CarlKuhligk/ATtiny85-Fan-Controller/documentation/box.PNG

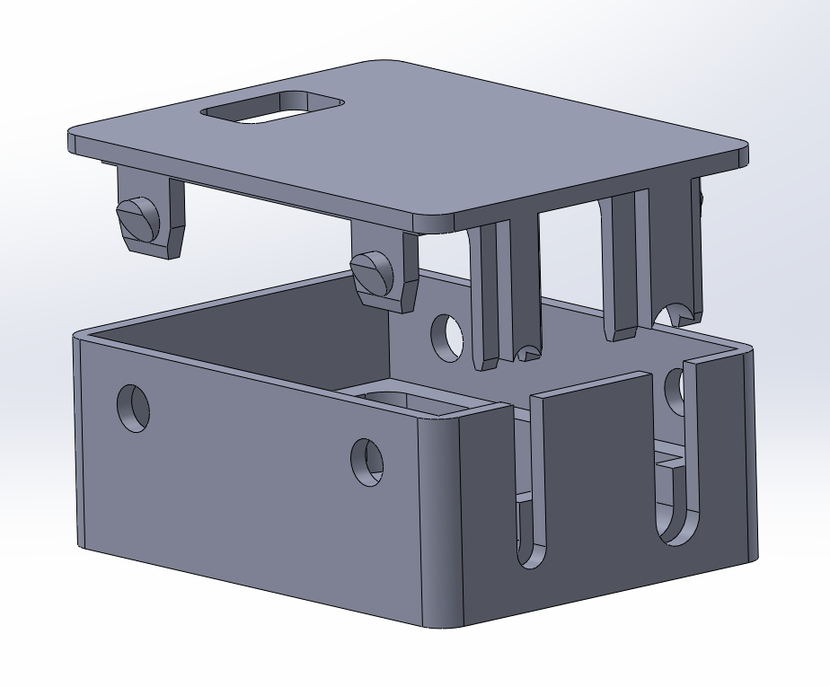
documentation/box.PNG
