CarlKuhligk/ATtiny85-Fan-Controller/documentation/IMG_20220520_110706.jpg

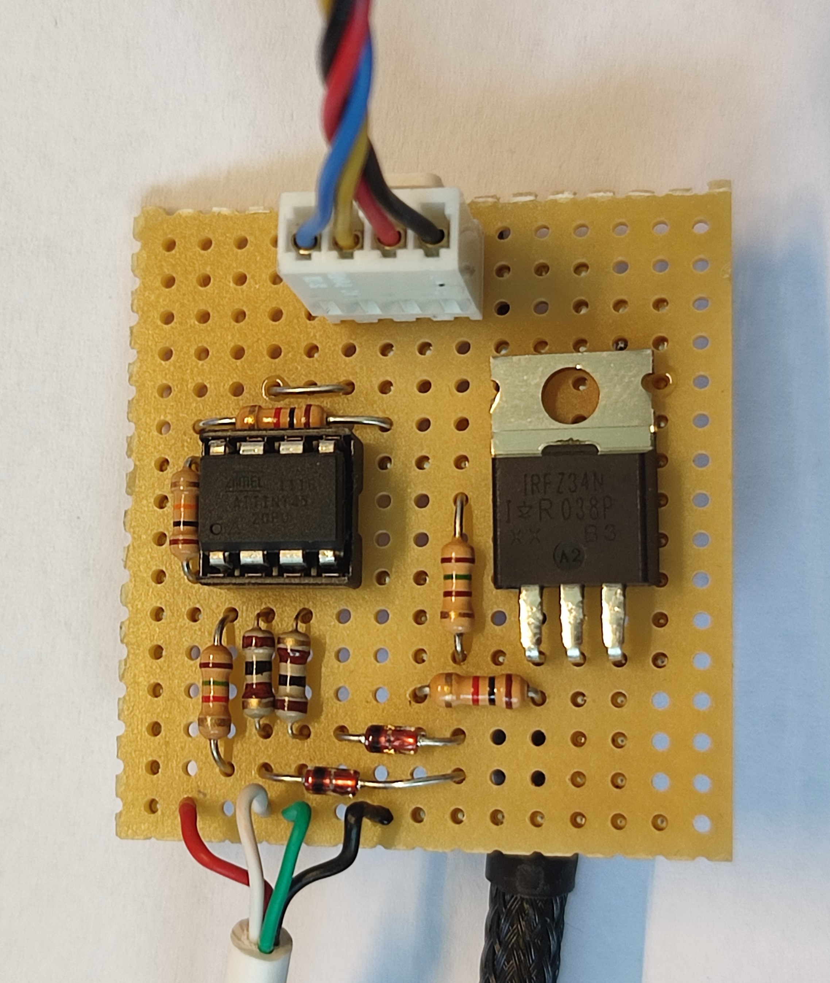
documentation/IMG_20220520_110706.jpg
