CarlKuhligk/ATtiny85-Fan-Controller/documentation/IMG_20220520_110726.jpg

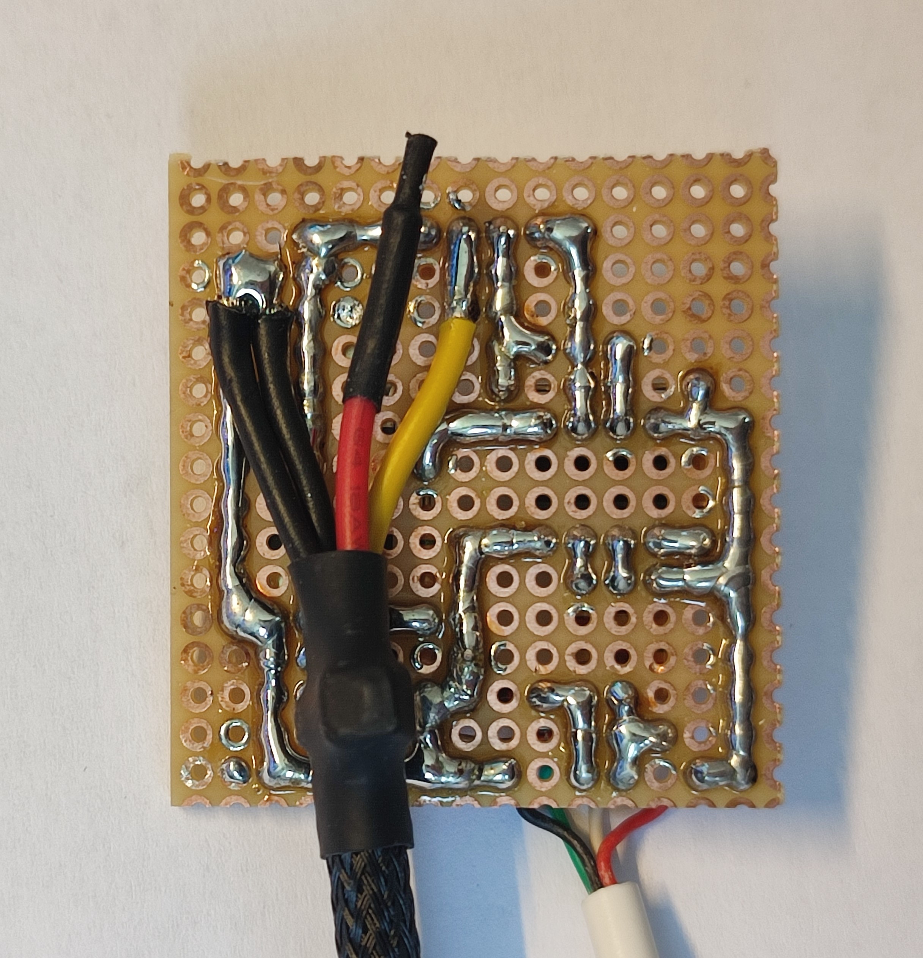
documentation/IMG_20220520_110726.jpg
